skvark/Arduino-Spectrum-VU-meter/circuit_diagrams/RGB_shield_circuit.png

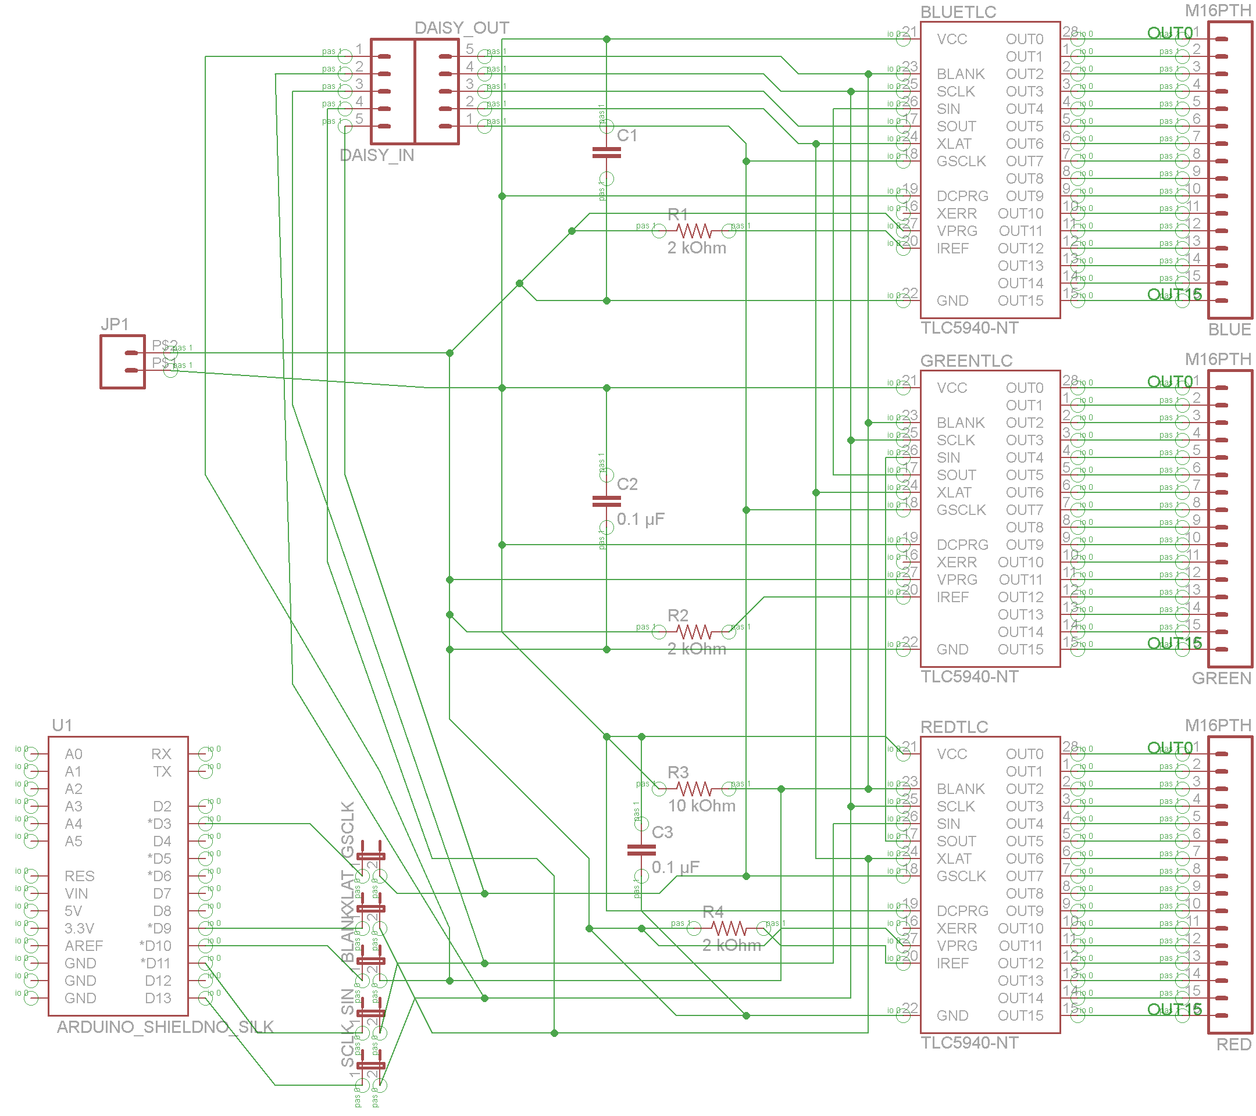
circuit_diagrams/RGB_shield_circuit.png
