skvark/Arduino-Spectrum-VU-meter/FFT_animation.ino

#include <avr/pgmspace.h>
#include "Tlc5940.h"

 /* fix_fft.c - Fixed-point in-place Fast Fourier Transform  */
 /*
   All data are fixed-point short integers, in which -32768
  to +32768 represent -1.0 to +1.0 respectively. Integer
  arithmetic is used for speed, instead of the more natural
  floating-point.

  Written by:  Tom Roberts  11/8/89
  Made portable:  Malcolm Slaney 12/15/94 malcolm@interval.com
  Enhanced:  Dimitrios P. Bouras  14 Jun 2006 dbouras@ieee.org
  Adapted for Arduino: Anatoly Kuzmenko 6 Feb 2011 k_anatoly@hotmail.com
  Modified for RGB screen: Olli-Pekka Heinisuo 20 Aug 2012 o-p@unknownpixels.com
 */

 //**************************************************************************************************
 #define N_WAVE          1024    /* full length of Sinewave[] */
 #define LOG2_N_WAVE     10      /* log2(N_WAVE) */

 #define FFT_SIZE       128 
 #define log2FFT       7
 #define N             (2 * FFT_SIZE)
 #define log2N         (log2FFT + 1)

 const prog_int16_t Sinewave[N_WAVE-N_WAVE/4] PROGMEM = {
   0,    201,    402,    603,    804,   1005,   1206,   1406,
   1607,   1808,   2009,   2209,   2410,   2610,   2811,   3011,
   3211,   3411,   3611,   3811,   4011,   4210,   4409,   4608,
   4807,   5006,   5205,   5403,   5601,   5799,   5997,   6195,
   6392,   6589,   6786,   6982,   7179,   7375,   7571,   7766,
   7961,   8156,   8351,   8545,   8739,   8932,   9126,   9319,
   9511,   9703,   9895,  10087,  10278,  10469,  10659,  10849,
   11038,  11227,  11416,  11604,  11792,  11980,  12166,  12353,
   12539,  12724,  12909,  13094,  13278,  13462,  13645,  13827,
   14009,  14191,  14372,  14552,  14732,  14911,  15090,  15268,
   15446,  15623,  15799,  15975,  16150,  16325,  16499,  16672,
   16845,  17017,  17189,  17360,  17530,  17699,  17868,  18036,
   18204,  18371,  18537,  18702,  18867,  19031,  19194,  19357,
   19519,  19680,  19840,  20000,  20159,  20317,  20474,  20631,
   20787,  20942,  21096,  21249,  21402,  21554,  21705,  21855,
   22004,  22153,  22301,  22448,  22594,  22739,  22883,  23027,
   23169,  23311,  23452,  23592,  23731,  23869,  24006,  24143,
   24278,  24413,  24546,  24679,  24811,  24942,  25072,  25201,
   25329,  25456,  25582,  25707,  25831,  25954,  26077,  26198,
   26318,  26437,  26556,  26673,  26789,  26905,  27019,  27132,
   27244,  27355,  27466,  27575,  27683,  27790,  27896,  28001,
   28105,  28208,  28309,  28410,  28510,  28608,  28706,  28802,
   28897,  28992,  29085,  29177,  29268,  29358,  29446,  29534,
   29621,  29706,  29790,  29873,  29955,  30036,  30116,  30195,
   30272,  30349,  30424,  30498,  30571,  30643,  30713,  30783,
   30851,  30918,  30984,  31049,  31113,  31175,  31236,  31297,
   31356,  31413,  31470,  31525,  31580,  31633,  31684,  31735,
   31785,  31833,  31880,  31926,  31970,  32014,  32056,  32097,
   32137,  32176,  32213,  32249,  32284,  32318,  32350,  32382,
   32412,  32441,  32468,  32495,  32520,  32544,  32567,  32588,
   32609,  32628,  32646,  32662,  32678,  32692,  32705,  32717,
   32727,  32736,  32744,  32751,  32757,  32761,  32764,  32766,
   32767,  32766,  32764,  32761,  32757,  32751,  32744,  32736,
   32727,  32717,  32705,  32692,  32678,  32662,  32646,  32628,
   32609,  32588,  32567,  32544,  32520,  32495,  32468,  32441,
   32412,  32382,  32350,  32318,  32284,  32249,  32213,  32176,
   32137,  32097,  32056,  32014,  31970,  31926,  31880,  31833,
   31785,  31735,  31684,  31633,  31580,  31525,  31470,  31413,
   31356,  31297,  31236,  31175,  31113,  31049,  30984,  30918,
   30851,  30783,  30713,  30643,  30571,  30498,  30424,  30349,
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
 };

 int fix_fft(int fr[], int fi[], int m )
 {
   int mr, nn, i, j, l, k, istep, n, scale, shift;
   int qr, qi, tr, ti, wr, wi;

   n = 1 << m;

   /* max FFT size = N_WAVE */
   if (n > N_WAVE)
     return -1;

   mr = 0;
   nn = n - 1;
   scale = 0;

   /* decimation in time - re-order data */
   for (m=1; m<=nn; ++m) {
     l = n;
     do {
       l >>= 1;
     } 
     while (mr+l > nn);
     mr = (mr & (l-1)) + l;

     if (mr <= m)
       continue;
     tr = fr[m];
     fr[m] = fr[mr];
     fr[mr] = tr;
     ti = fi[m];
     fi[m] = fi[mr];
     fi[mr] = ti;
   }

   l = 1;
   k = LOG2_N_WAVE-1;
   while (l < n) {
     shift = 1;
     istep = l << 1;
     for (m=0; m<l; ++m) {
       j = m << k;
       /* 0 <= j < N_WAVE/2 */
       wr =  pgm_read_word(&Sinewave[j+N_WAVE/4]);
       wi = -pgm_read_word(&Sinewave[j]);

       wr >>= 1;
       wi >>= 1;

       for (i=m; i<n; i+=istep) {
         j = i + l;
         tr = ((long)wr*(long)fr[j] - (long)wi*(long)fi[j])>>15;
         ti = ((long)wr*(long)fi[j] + (long)wi*(long)fr[j])>>15;
         qr = fr[i];
         qi = fi[i];

         qr >>= 1;
         qi >>= 1;

         fr[j] = qr - tr;
         fi[j] = qi - ti;
         fr[i] = qr + tr;
         fi[i] = qi + ti;
       }
     }
     --k;
     l = istep;
   }
   return scale;
 }

 int fix_fftr(int f[], int m )
 {
   int i, Nt = 1<<(m-1),  scale = 0;
   int tt, *fr=f, *fi=&f[Nt];

   scale = fix_fft(fi, fr, m-1 );
   return scale;
 }
 //**************************************************************************************************

 int       x[N], fx[N];
 int      incomingByte; 
 int   i, count, scale;
 int b1 = 0, b2 = 0, b3 = 0;
 int b4 = 0, b5 = 0, b6 = 0;
 int bb1 = 0, bb2 = 0, bb3 = 0;
 int bb4 = 0, bb5 = 0, bb6 = 0;

 int sdvig = 32768; //DC bias of the ADC, approxim +2.5V. (kompensaciya post. sostavlyauschei).
 int minim = 0; 
 int maxim = 32000; 
 int vrem;
 float kdmp = 0.95;  //Smoothing constant. 
 float kary = 0.999;  //AGC time constant. 
 //AGC affects visual display only, no AGC on analog part of the system

 void setup() {
 Tlc.init();
 }

 void loop()
 {
   
 //Filling up input raw data array x[];
 // 14.6 msec for ADC and 12.4 msec everything else, TOTAL = 27 msec if FFT size = 64 (N=128).
 // 28.8 msec for ADC and 27.1 msec everything else, TOTAL = 55.9 msec if FFT size = 128 (N).

   ADCSRA = 0x87;
   // turn on adc, freq = 1/128 , 125 kHz.  
   ADMUX = 0x60;
   //Bit 5 – ADLAR: ADC Left Adjust Result
   ADCSRA |= (1<<ADSC);
   //    while((ADCSRA&(1<<ADIF)) == 0); //Discard first conversion result.
   while(!(ADCSRA & 0x10));

   for(i=0; i<N; i++ ) {
     ADCSRA |= (1<<ADSC);
     //    while((ADCSRA&(1<<ADIF)) == 0);
     while(!(ADCSRA & 0x10));

     x[i] = ADCL;
     x[i] += (ADCH << 8);  
   }  

   ADCSRA = 0x00;

   for (i=0; i<N; i++){
     x[i] -=  sdvig;
     if (i & 0x01)
       fx[(N+i)>>1] = x[i] ;
     else
       fx[i>>1] = x[i] ;
   }  

 //Performing FFT, getting fx[] array, where each element represents
 //frequency bin with width 65 Hz.

   fix_fftr( fx, log2N );
   

 // Calculation of the magnitude:
   for (i=0; i<N/2; i++)
   {
     fx[i] = sqrt((long)fx[i] * (long)fx[i] + (long)fx[i+N/2] * (long)fx[i+N/2]);
   }

  /// ********* Screen animation starts here ***************///
  /// ********* Olli-Pekka Heinisuo 2012     ***************///

   b1 = 0;  //Reset 
   b2 = 0;
   b3 = 0;
   b4 = 0;
   b5 = 0;
   b6 = 0;
   
   for ( count = 40; count < 50; count++ )
   {
     b1 = b1 + fx[count];
   }
   if (b1 < 0) {
    b1 /= -1; 
   }
   if (b1 > 25000) {
    b1 = 7;
    } else {
      b1 /= 3500;
    }
   for ( count = 51; count < 61; count++ )
   {
     b2 = b2 + fx[count];
   }
   if (b2 < 0) {
    b2 /= -1; 
   }
    if (b2 > 25000) {
    b1 = 7;
    } else {
      b2 /= 3500;
    }
   for ( count = 62; count < 72; count++ )
   {
     b3 = b3 + fx[count];
   }
     if (b3 > 25000) {
    b1 = 7;
    } else {
      b3 /= 3500;
    }
   for ( count = 73; count < 83; count++ )
   {
     b4 = b4 + fx[count];
   }
    if (b4 > 25000) {
    b1 = 7;
    } else {
      b4 /= 3500;
    }
   for ( count = 84; count < 94; count++ )
   {
     b5 = b5 + fx[count];
   }
    if (b5 > 25000) {
    b1 = 7;
    } else {
      b5 /= 3500;
    }
   for ( count = 95; count < 110; count++ )
   {
     b6 = b6 + fx[count];
   }
     if (b6 > 25000) {
    b1 = 7;
    } else {
      b6 /= 3500;
    }

  // The screen consist of 6 bars
  // Every led is capable of displaying RGB-colors and all the combinations
  // The values for addressing are following:
  
  // redbar1 = 0 - 7
  // greenbar1 = 16 - 23
  // bluebar1 = 32 - 39
  // redbar2 = 8 - 15
  // greenbar2 = 24 - 31
  // bluebar2 = 40 - 47
  
  // redbar3 = 48 - 55
  // greenbar3 = 64 - 71
  // bluebar3 = 80 - 87
  // redbar4 = 56 - 63
  // greenbar4 = 72 - 79
  // bluebar4 = 88 - 95
  
  // redbar5 = 96 - 103
  // greenbar5 = 112 - 119
  // bluebar5 = 128 - 135
  // redbar6 = 104 - 111
  // greenbar6 = 120 - 127
  // bluebar6 = 136 - 143
  
  for (int i = 0; i < 7; ++i) {
      if (i > 0 + b1) {
        Tlc.set(i, 0);
      } else {
        Tlc.set(i, 3000);
      }
  }
   for (int i = 8; i < 16; ++i) {
      if (i > 8 + b2) {
        Tlc.set(i, 0);
      } else {
        Tlc.set(i, 3000);
      }
  }
   for (int i = 48; i < 56; ++i) {
      if (i > 48 + b3) {
        Tlc.set(i, 0);
      } else {
        Tlc.set(i, 3000);
      }
  }
   for (int i = 56; i < 64; ++i) {
      if (i > 56 + b4) {
        Tlc.set(i, 0);
      } else {
        Tlc.set(i, 3000);
      }
  }
   for (int i = 96; i < 104; ++i) {
      if (i > 96 + b5) {
        Tlc.set(i, 0);
      } else {
        Tlc.set(i, 3000);
      }
  }
   for (int i = 104; i < 112; ++i) {
      if (i > 104 + b6 ) {
        Tlc.set(i, 0);
      } else {
        Tlc.set(i, 3000);
      }
  }
  
  Tlc.update();
  
  bb1 = b1;
  bb2 = b2;
  bb3 = b3;
  bb4 = b4;
  bb5 = b5;
  bb6 = b6;
}
